hamling-ling/fly-car/research/camera_capture_q/README.md

# Uno Q で USB カメラから 1 枚取る

2026-10-07。ハエの目の代わりにできるか、Arduino Uno Q に Logitech Brio 100 を載せて確認した。スクリプトは `capture.py`。Q 上では `/home/arduino/camera_capture_q/capture.py` に置いて動かした。

Q は Debian 13、Linux 6.16.7、Python 3.13.5、OpenCV 4.10.0。ボードのホスト名は `uno-q-1`、Wi-Fi は `192.168.0.28`、mDNS 名は `uno-q-1.local`。ログインは `arduino`。

## つなぎ方

USB-C を PC に刺しているあいだ、Q はデバイスモードで adb ができる。この状態では USB ホストのバスが空で、カメラは列挙されない。`/dev/video0` と `/dev/video1` は Qualcomm Venus のデコーダとエンコーダである。

PC から USB を外し、給電できるハブの先にカメラを置くとホストになる。今回見えたのは Genesys Logic のハブ（`05e3:0610`、`05e3:0625`）と、その先の Brio 100（`046d:094c`、UVC 1.00）だった。キャプチャノードは `/dev/video0`（`uvcvideo`）。`/dev/video1` も Brio だがキャプチャではない。Venus は `/dev/video2` と `/dev/video3` にずれる。スクリプトはメモリ間転送のノードを除き、最初のキャプチャノードを使う。

このあとの撮影は `ssh arduino@uno-q-1.local` から行った。

## 解像度

ハエの目として横長が欲しいので、既定は 1280×720 にした。Brio 100 の 16:9 はこのサイズと 1920×1080 で、MJPG ならどちらも 30 fps まで出せる。同じサイズの YUYV は 5 fps しかない。スクリプトは MJPG を指定してからサイズをセットする。1920×1080 は `--width 1920 --height 1080`。

露出を待たずに撮った 640×480 は mean 5.6、std 15.8、28,824 バイトで、ほぼ黒だった。1280×720 を 8 フレームだけで撮ったものも mean 13.9、std 32.6、72,213 バイトで、まだ暗かった。

## 明暗

Brio 100 の自動露出は Aperture Priority（`auto_exposure=3`）。`exposure_time_absolute` の単位は 100 µs で、範囲は 5 から 2500（0.5 ms から 250 ms）。ゲインは 0 から 255。

30 fps に固定するとシャッターは約 33 ms（値 333）で頭打ちになり、夕方の部屋が暗いままになる。`exposure_dynamic_framerate=1` にして fps を固定しないと、シャッターは伸びる。夕方のこの部屋では次のように落ち着いた。

| フレーム | 平均輝度 | シャッター | ゲイン |
| --- | ---: | ---: | ---: |
| 5 | 24.6 | 33.3 ms | 187 |
| 10 | 36.4 | 50.0 ms | 179 |
| 15 | 45.1 | 66.6 ms | 207 |
| 20 | 68.9 | 66.6 ms | 215 |
| 40 | 66.9 | 66.6 ms | 215 |

20 フレームあたりで安定した。中央値は 26 から 27、95 パーセンタイルと 99 パーセンタイルは 254 で、白い服が上限に当たっていた。本棚の文字と椅子のメッシュは読めた。黒い戸棚は露出不足ではなく黒い面である。

そのあとガンマ 0.8 を全画素にかける。太陽光でも夕方でも同じカーブで、白付近はほとんど動かず、影だけ持ち上がる。最終フレームは 1280×720、シャッター 66.6 ms、ゲイン 215、補正前の平均 69.3、補正後の平均 78.9、180,444 バイトだった。

太陽光ではまだ撮っていない。自動露出が同じハイライト目標までシャッターを短くする、という前提で揃える作りである。ゲイン 215 の夕方は、ゲインの低い太陽光よりノイズが多い。明るさの段差は寄せられるが、ノイズの差は残る。シャッターが 240 ms 以上、またはゲインが 250 以上で平均輝度が 40 未満のときは、スクリプトは揃わないと知らせて終了コード 3 で終わる。真っ暗は補正できない。

## fps

一定ではない。シャッターに追従する。光が止まっているあいだはほぼ一定で、今回の安定後 20 フレームは 63.9 ms から 68.6 ms、平均 67.0 ms、14.9 fps だった。1280×720 の MJPG では、明るいと 30 fps まで上がり、シャッター上限の 250 ms では約 4 fps まで下がる。

## 再現

Q 上で次を実行する。`v4l2-ctl` と `python3-opencv` を使う。

```bash
python3 /home/arduino/camera_capture_q/capture.py --output /home/arduino/camera_capture_q/capture.jpg
```

ノードだけ見るときは `--list`。影の持ち上げを切るときは `--gamma 1`。
