hamling-ling/fly-car/poster/color_wheel_table.md

# 近づいてくる色と車輪

半画面の色は、近づいてくる色である。青ならその側の DNp01 が発火し、赤ならその側の DNa02 が発火する。白の側はゼロとする。ガウスのしみ出しは入れていない。赤が左右の画面を満たしたときの停止は、方程式の外の安全装置である。

| L | R | $r^{\mathrm{DNp01}}_L$ | $r^{\mathrm{DNp01}}_R$ | $r^{\mathrm{DNa02}}_L$ | $r^{\mathrm{DNa02}}_R$ | 車輪 L | 車輪 R |
|---|---|---|---|---|---|---|---|
| 青 | 青 | あり | あり | なし | なし | 後 | 後 |
| 青 | 白 | あり | なし | なし | なし | 後 | 強後 |
| 青 | 赤 | あり | なし | なし | あり | 前 | 後 |
| 赤 | 青 | なし | あり | あり | なし | 後 | 前 |
| 赤 | 白 | なし | なし | あり | なし | 弱前 | 前 |
| 赤 | 赤 | なし | なし | あり | あり | 前 | 前 |
| 白 | 青 | なし | あり | なし | なし | 強後 | 後 |
| 白 | 白 | なし | なし | なし | なし | 止 | 止 |
| 白 | 赤 | なし | なし | なし | あり | 前 | 弱前 |
