hamling-ling/fly-car/poster/fig2_approach.png

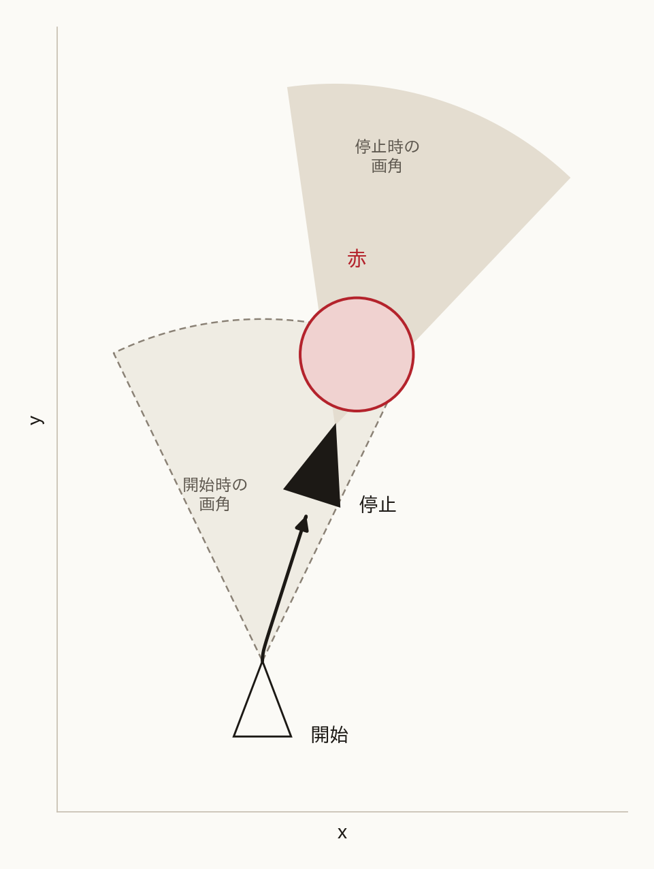
poster/fig2_approach.png
