hamling-ling/fly-car/poster/fig3_escape.png

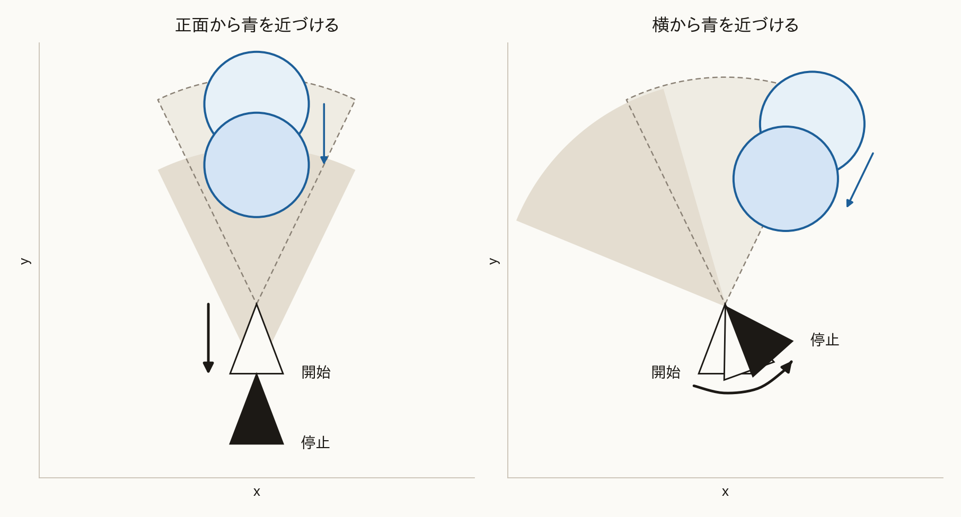
poster/fig3_escape.png
