hamling-ling/fly-car/poster/fig5_series.png

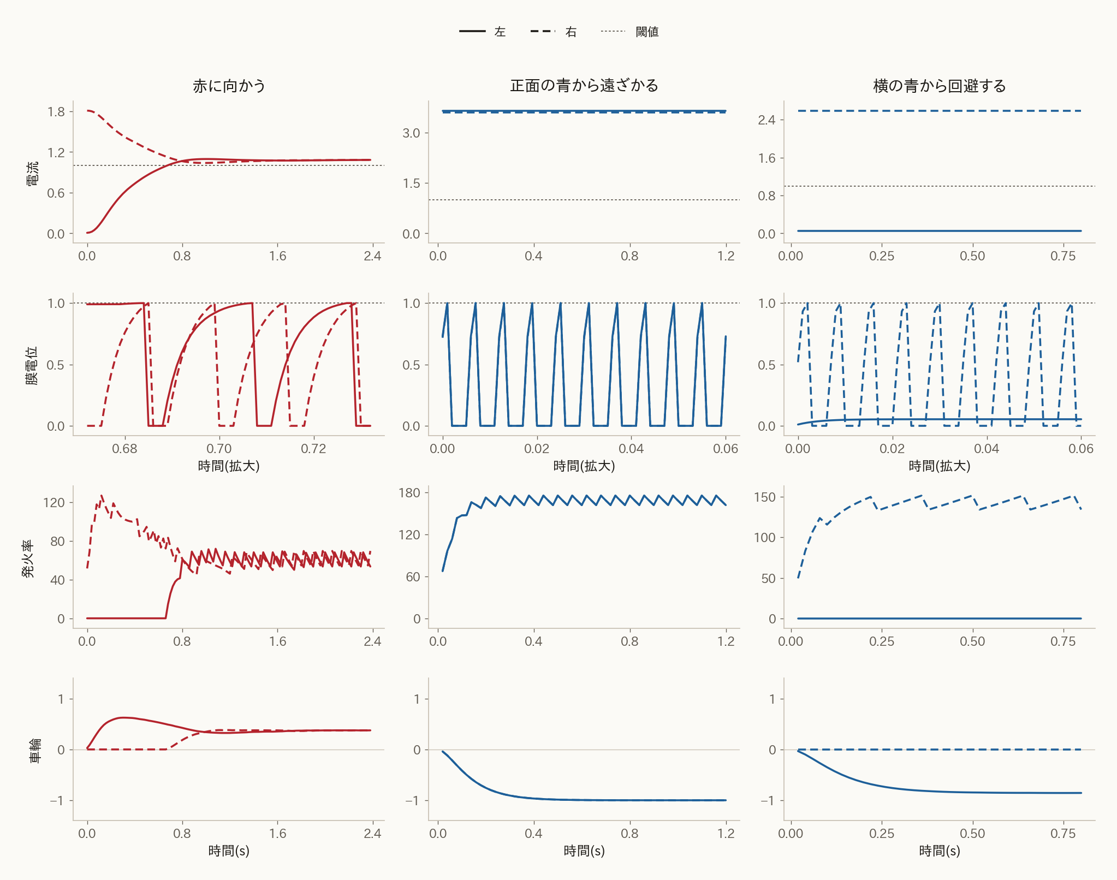
poster/fig5_series.png
