hamling-ling/fly-car/poster/fig8_plate.png

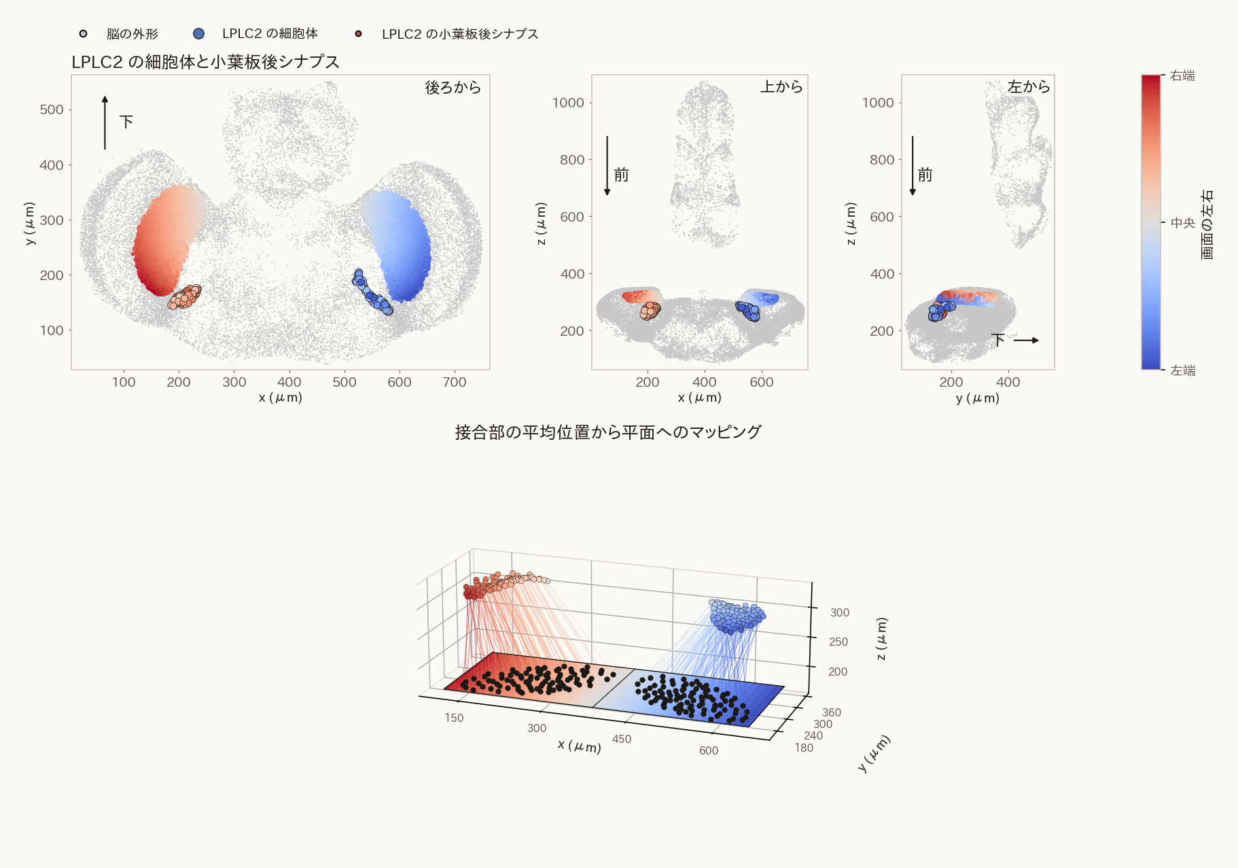
poster/fig8_plate.png
