hamling-ling/fly-car/poster/frames/approach.jpg

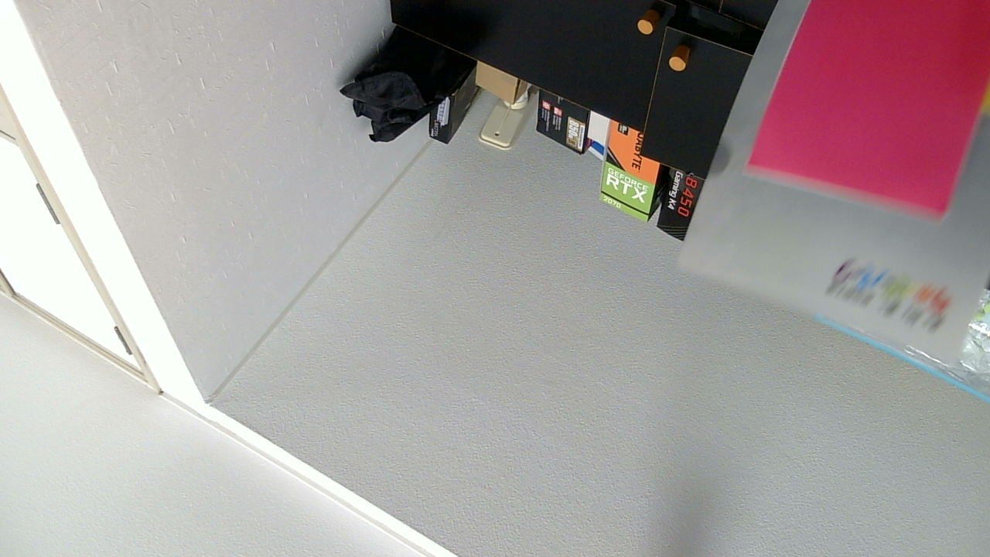
poster/frames/approach.jpg
