hamling-ling/fly-car/poster/frames/frontal.jpg

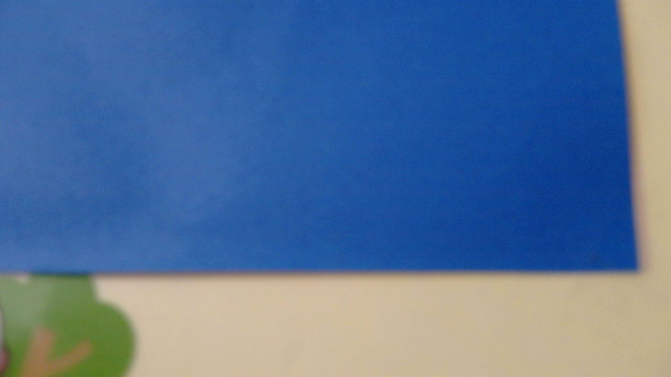
poster/frames/frontal.jpg
