hamling-ling/fly-car/poster/frames/side.jpg

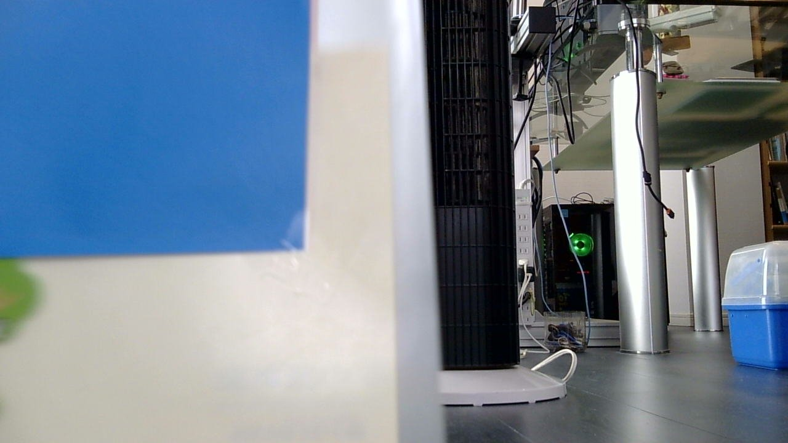
poster/frames/side.jpg
