hamling-ling/fly-car/poster/fig7_lobula.pdf

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

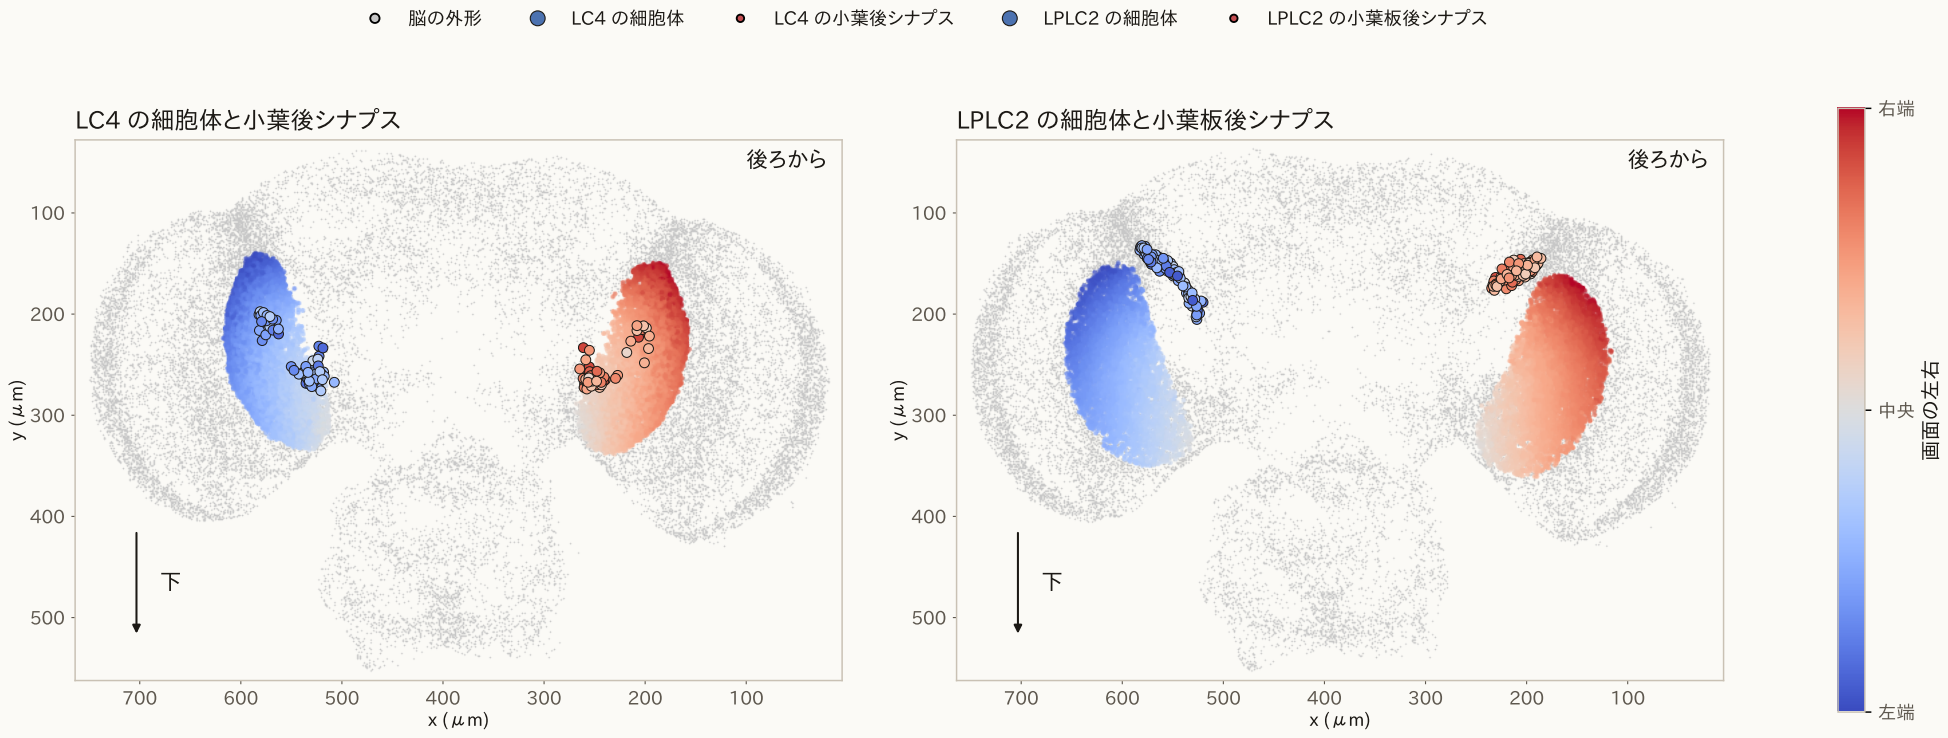
[picture p21: page 1]
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
