hamling-ling/fly-car/poster/fig8_plate.pdf

### LPLC2

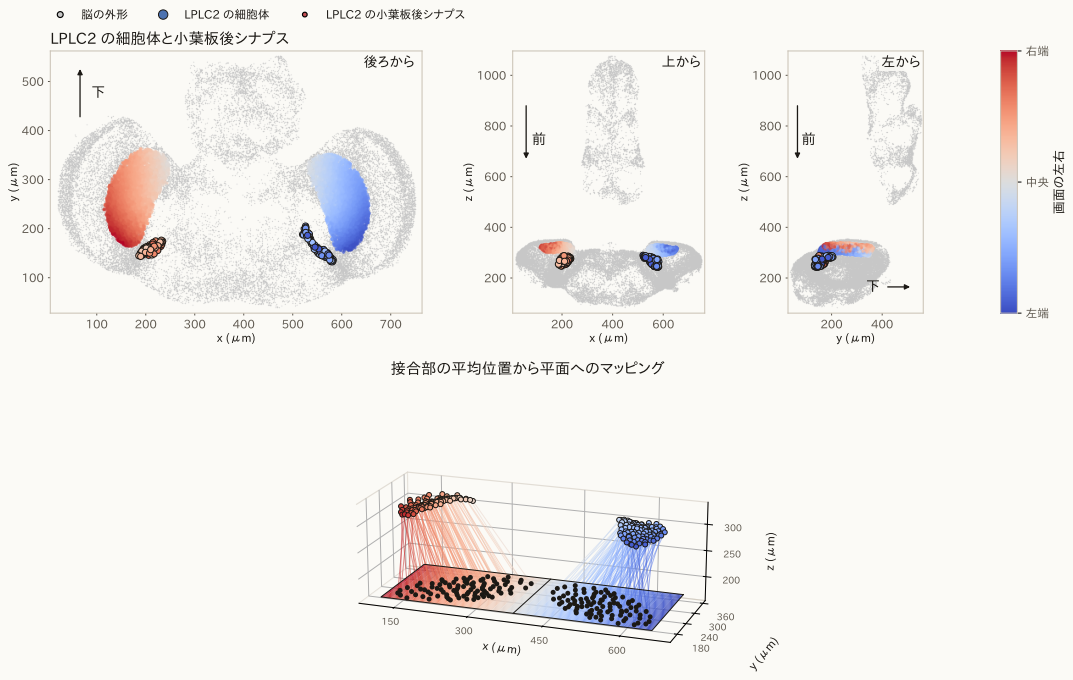
[picture p23: page 1]
LPLC2
