hamling-ling/fly-car/poster/fig4_wheels.pdf

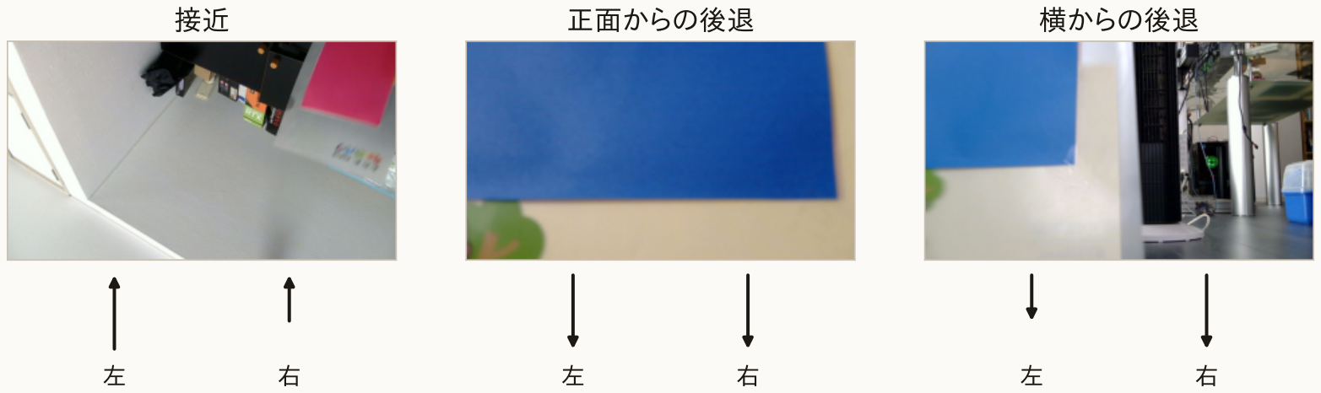
[picture p26: page 1]
