hamling-ling/fly-car/(commit log)

2026-10-05 巨大線維の loom 回路と DNa02 の走性回路を切り出すスクリプトを追加する
    MaleCNS の化学結合から回路を書き出すスクリプトと、机上の走行ノート、手順を README に追加する。
2026-10-05 README に Release からのデータ取得手順を追加する
2026-10-07 Arduino Uno Q 上で USB Camera のキャプチャを検証。結果をREADME.mdに記録。
2026-10-09 半画面の赤と青から停止・旋回・前進を出す机上応答を追加し、5ステップを pytest で回せるようにする
2026-10-10 図の日本語フォントを japanize_matplotlib の import だけにする
2026-10-10 カメラ画角の走行を flycar に出し、赤が無い青は指令を青のままにする
2026-10-10 前進とヨーを発火率の和と差にし、赤が左右を埋めたときだけ安全停止する
2026-10-11 コネクトームの切り出しを scripts に移し、トップの README を環境と車輪の式にする
2026-10-11 青のヨーを赤より強くし、正面の赤と右の青が避けてから赤の前で止まるようにする
2026-10-11 README の走行則を記号にし、システム概要と 20 ms のシーケンスを書く
2026-10-12 Add motor test program
2026-10-12 ブラウザからカメラを見ながら十字キーで車輪を動かすラジコンアプリを追加する。
2026-10-12 ライブラリ flycar を src に移し、Uno Q の本番アプリ src/flycar_q を作る
2026-10-12 シミュレーションのノートを research/notebooks に移す
2026-10-12 Uno Q でカメラの赤と青を Plant.steps に通し、車輪のパルスにする
2026-10-12 ラジコンに反時計回りの倍率を付け、速度40で合った1.62を初期値にする
    速度67では1.17のほうがよかったので、速度ごとの式にはしていない。
2026-10-13 半画面4%と赤の回転半径0.10mに合わせ、色範囲を10/12の見本にする
2026-10-13 矩形で色見本を集めるアプリと、見た目で決めた赤青の分類を足す
2026-10-14 色紙の4点から赤と青の下限を求め、設定ファイルを占有判定に使う
2026-10-18 左を逆つなぎにして倍率を外し、動き出し未満の指令は0にする
2026-10-18 左右の指令を直接入れる調整アプリと、直進の生値を残す
2026-10-18 直進の折れ線で左の指令を置き換え、ラジコンでも選べるようにする
2026-10-18 青が優勢なら後退し、赤のヨー係数を1.25にする
2026-10-18 ループの期限を Next にまとめ、占有と膜とログで同じ判定を使う
2026-10-18 1秒ごとのログにカメラfpsとstepsの平均時間を足す
2026-10-19 点マトリクスに占有と車輪を出し、赤の検知と前進を赤くする
2026-10-20 flycar_q の README にデータフローを足し、LC4 と LPLC2 を省いても電流が同じ理由を書く
2026-11-01 LC4 と LPLC2 の位置対応と、視角と拡大速度で分けた loom のノートを追加する
2026-11-01 MaleCNS の表の取得と、LC4 と LPLC2 の画面対応をスクリプトで再現できるようにする
2026-11-01 視角と拡大から DNp01 の電流を作り、実機の紙の接近に合わせて手で置いた定数を入れる。
    青の占有は電流にしない。LC4 のシグモイドは中心 0.20 rad/s、幅 0.10、拡大の項だけ 5 倍。発火率は 50 ms、青のヨーは 18。
2026-11-03 だいたい真ん中の青はまっすぐ下げ、片側の青は遠い輪だけを強く後退させる。
2026-11-03 ポスター原稿に、モデルの式と接近・逃避・実機の図をまとめる。
2026-11-03 行内数式の前後に空白を入れて GitHub で描画する。
2026-11-04 接近は LPLC2、逃避は LC4 に分け、車輪は反対側の発火率をならして出す。数値計算の図と式のノートをそのモデルに合わせる。
2026-11-05 トップの説明は電流と車輪の式だけにし、ポスターの行内数式を GitHub で描画する。
2026-11-05 接近は左右の PN の差にし、LPLC2 の視角は逃避へ戻す。全体の図と数値計算の図をその式で描く。
2026-11-06 題の直下に要旨を置く。赤が DNa02、青が DNp01 の電流になることと、ロボットで見た接近と逃避を先に書く。
2026-11-06 全体では、四本の膜電位をそれぞれの電流から求めると書く。赤は触角の濃度になり、同側の PN が促進し反対側が抑制する電流として DNa02 に入る。
2026-11-06 構造では、接合部を含むマス目の平均位置を画面上の位置にする。発火率と α は逃避の電流へ移し、モデル方程式の序文は画素からモーターへの入力までを述べる。
2026-11-06 接近の電流は、臭いが DNa02 に届く流れを式ごとに説明する。濃度は半分画面の平均とし、使わない R は消す。
    画素の広がりは左右の視野が正面で重なることから書き、文献を末尾に置く。表示した式は (1) から (21) まで番号を付ける。α は係数とし、ゲインは拡大のシグモイドに限る。
2026-11-06 逃避の電流は、拡大速度と視角の大きさが同側の DNp01 に足される流れを式ごとに説明する。
    膜の節は膜電位と発火率にし、漏れのある積分発火で求めると書く。車輪は反対側の発火率を指令にしてからならす。
2026-11-07 構造では、後ろから見た LC4 と LPLC2 を一枚にし、画面への対応は重なりの全幅 0.3 の図で示す。全体は、カメラ画像を細胞の動作モデルで処理し、左右のモーターへ動力を出すと書く。
2026-11-07 構造の重なりの図は、外側を固定して広げたあとの、接合部の平均位置と画面上の位置の対応だと書く。
2026-11-07 画素の広がりをやめ、左右の眼の範囲にある赤の割合と、細胞の位置にある青の割合を式にする。要旨と全体も、半分画面ではなく左右の眼の範囲と書く。
2026-11-07 数値計算は、左右の眼の範囲にある赤の割合と、細胞の位置にある縦一列の青の割合で描き直す。
2026-11-07 数値計算は、赤に向かう、正面の青から遠ざかる、横の青から回避する、の三枚にする。各図の左に経路、右に電流、膜電位、発火率、車輪を置く。
2026-11-08 端の赤の濃度に倍率を掛けて回頭を強め、青は縦一列の割合にし、止まったカメラは開き直す。
2026-11-09 flycar_q の README に、部品と配線、クラス図、主要処理のシーケンスを書く。
2026-11-09 ポスターの数式を、GitHub で添字と波括弧が残るように書く。
2026-11-09 ポスターの式番号を、GitHub でも式の右に出るように書く。
2026-11-10 片側の赤でも両輪が前へ出るよう、要旨と車輪の式と接近の図を現行の回頭に合わせる。
2026-11-10 poster.md の実機の章に動画へのリンクを設置
2026-11-10 poster.md に結論とまとめを記入
2026-11-10 付録の記載位置がおかしいのを修正
